khiem13052003/three_wheel_omni_robot/omni_robot_3D/gia công/Assem1.SLDASM

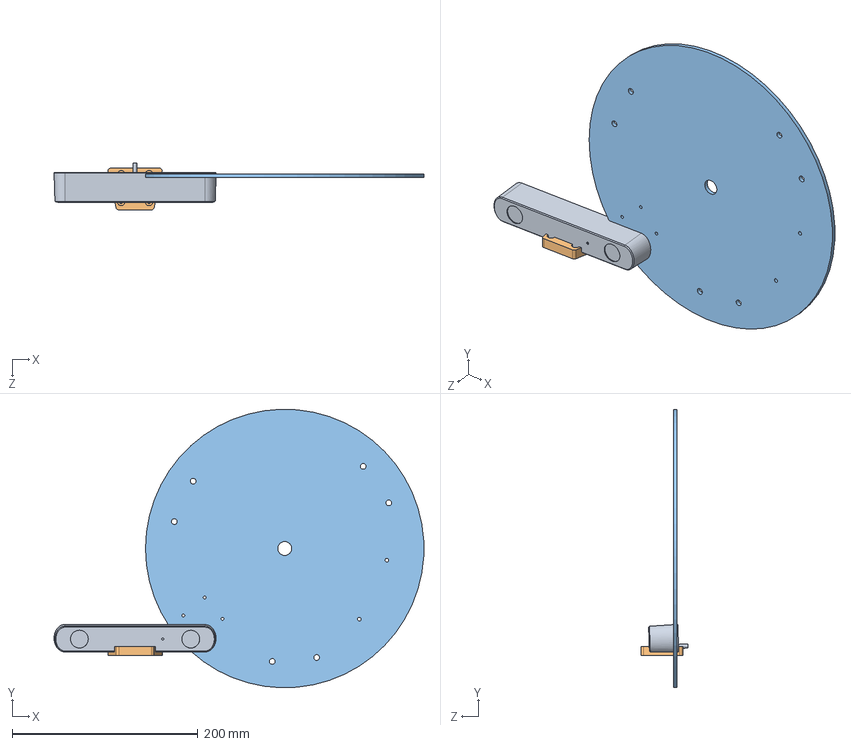
[picture p78: CAD file, 2026-04-22]
omni_robot_3D/gia công/Assem1.SLDASM
398.5 x 299.9 x 50.4 mm
DE_30_gc
camere_holder
ZED2
