khiem13052003/three_wheel_omni_robot/omni_robot_3D/Assemly.SLDASM

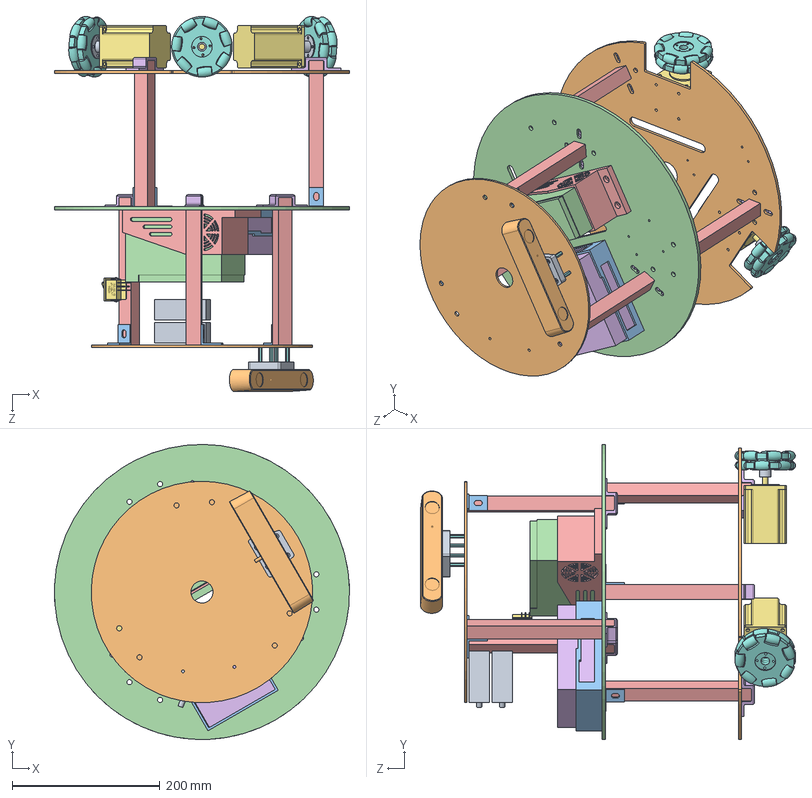
[picture p80: CAD file, 2026-04-22]
omni_robot_3D/Assemly.SLDASM
399.8 x 400.0 x 508.2 mm
BASE_R
JOINTS x 3
Omniwheel_82mm x 3
MOTOR x 3
PAS_U x 6
PILLER x 6
BASE_R_F2
KEGOC x 6
DE_30
RIGHT_BOX x 2
TRU_LUC_GIAC x 4
KCD4_ROCKET_SWITCH
JETSON
BATTERY_HOLDER
BATERY
ZED2
camere_holder
