khiem13052003/three_wheel_omni_robot/meshes/base_link.STL

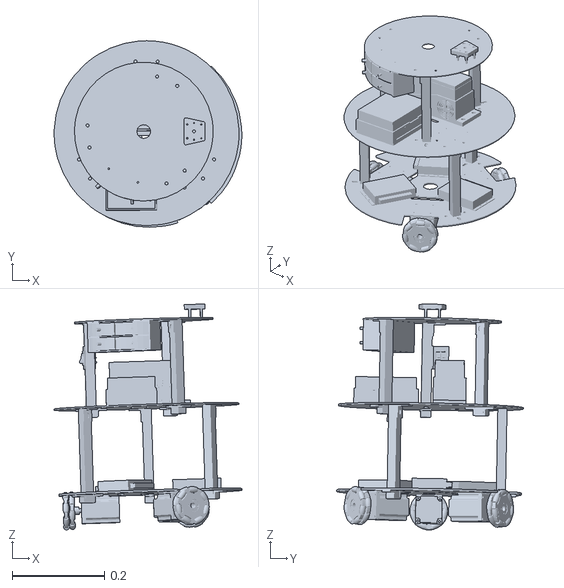
[picture p81: CAD file, 2025-07-12]
meshes/base_link.STL
0.406 x 0.403 x 0.489
