khiem13052003/three_wheel_omni_robot/omni_robot_3D/gia công/BASE_R_F2.SLDPRT

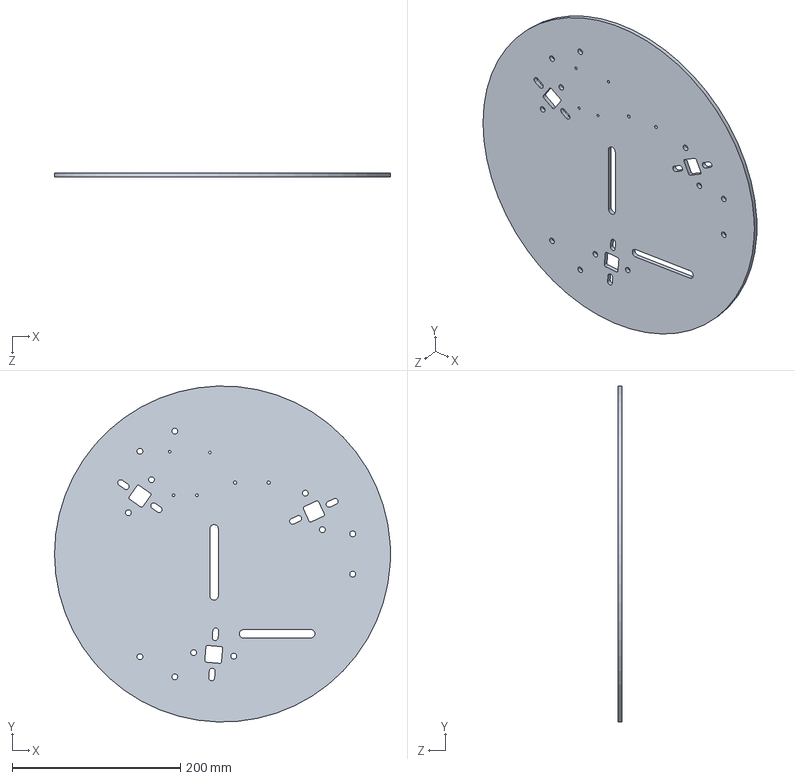
[picture p82: CAD file, 2026-04-22]
omni_robot_3D/gia công/BASE_R_F2.SLDPRT
400.0 x 399.8 x 5.00 mm
