khiem13052003/three_wheel_omni_robot/omni_robot_3D/gia công/clone1/HOPTHUOC.SLDPRT

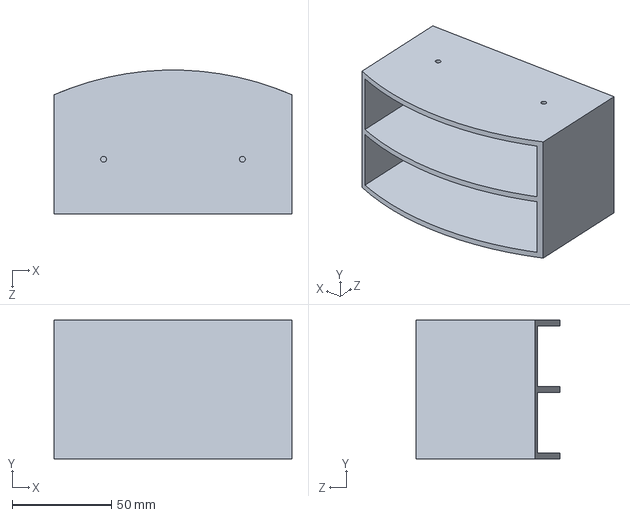
[picture p83: CAD file, 2026-04-22]
omni_robot_3D/gia công/clone1/HOPTHUOC.SLDPRT
120.0 x 70.0 x 72.4 mm
