khiem13052003/three_wheel_omni_robot/omni_robot_3D/PILLER_SWITCH.SLDPRT

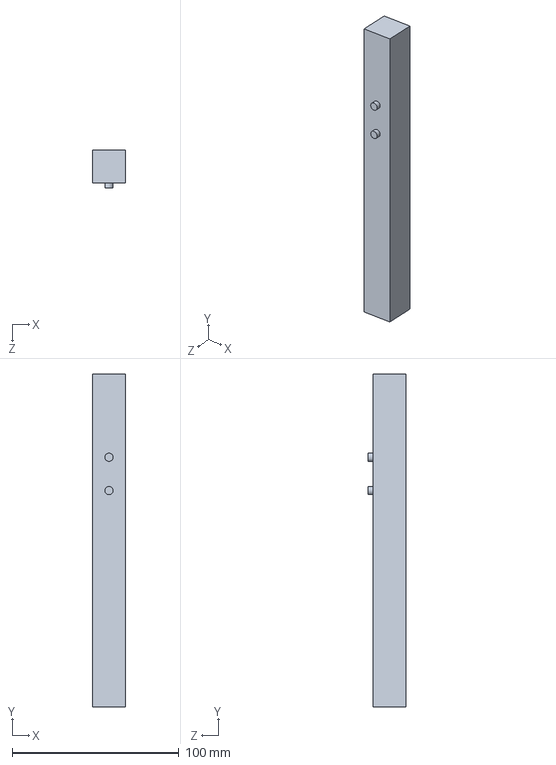
[picture p84: CAD file, 2026-04-22]
omni_robot_3D/PILLER_SWITCH.SLDPRT
20.0 x 200.0 x 23.0 mm
