khiem13052003/three_wheel_omni_robot/meshes/cam.STL

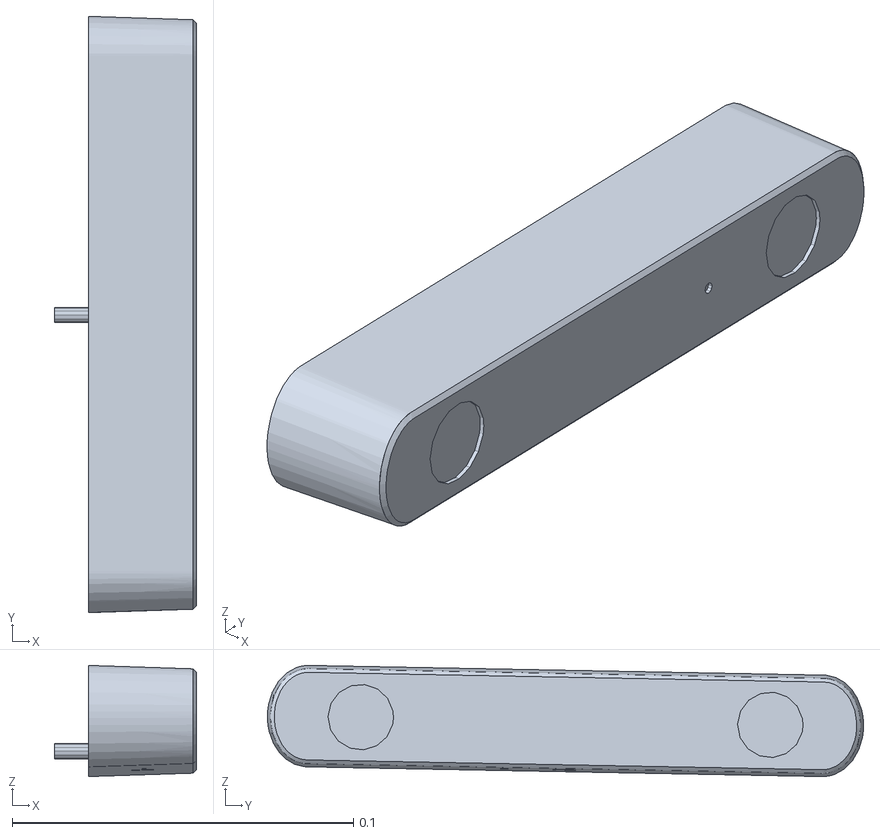
[picture p85: CAD file, 2025-07-12]
meshes/cam.STL
0.0416 x 0.175 x 0.0326
