khiem13052003/three_wheel_omni_robot/omni_robot_3D/gia công/clone1/KEGOC.SLDPRT

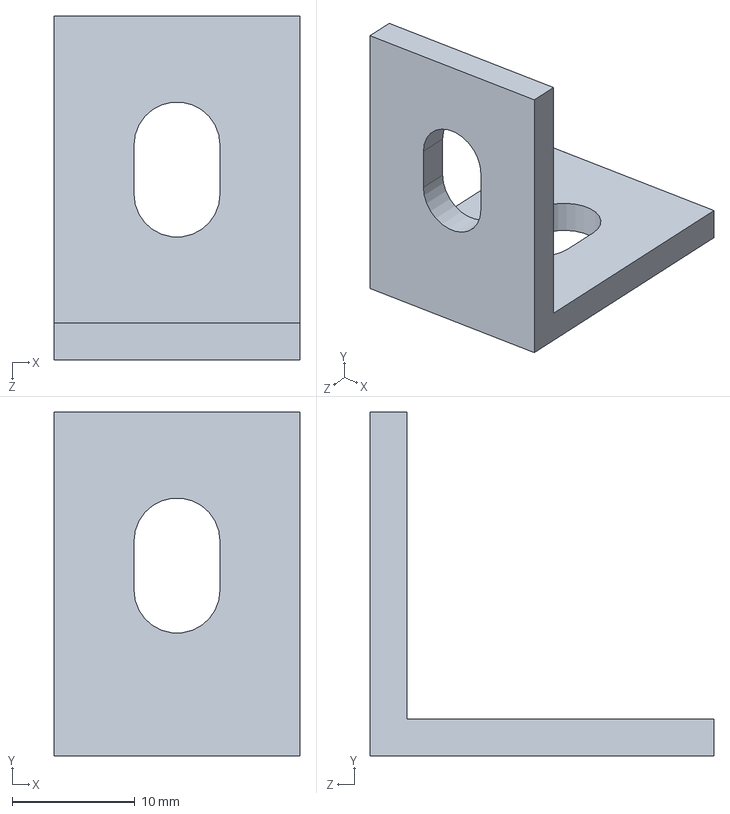
[picture p86: CAD file, 2026-04-22]
omni_robot_3D/gia công/clone1/KEGOC.SLDPRT
20.0 x 28.0 x 28.0 mm
