khiem13052003/three_wheel_omni_robot/omni_robot_3D/gia công/DE_JETSON.STL

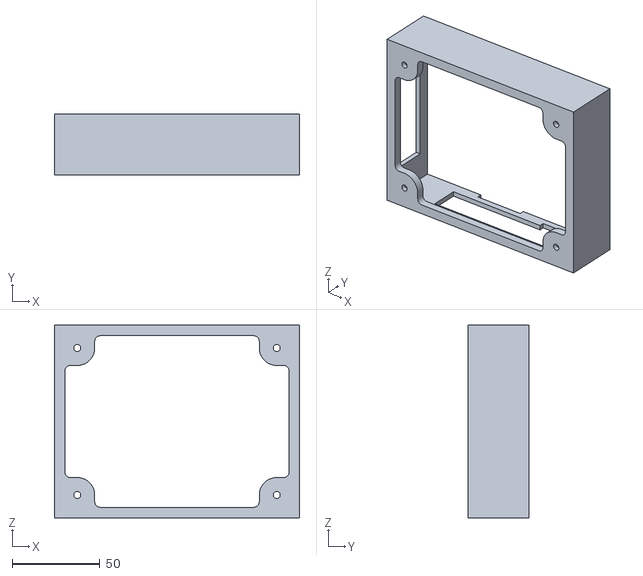
[picture p87: CAD file, 2026-04-22]
omni_robot_3D/gia công/DE_JETSON.STL
140.0 x 35.0 x 110.0
