khiem13052003/three_wheel_omni_robot/meshes/laser.STL

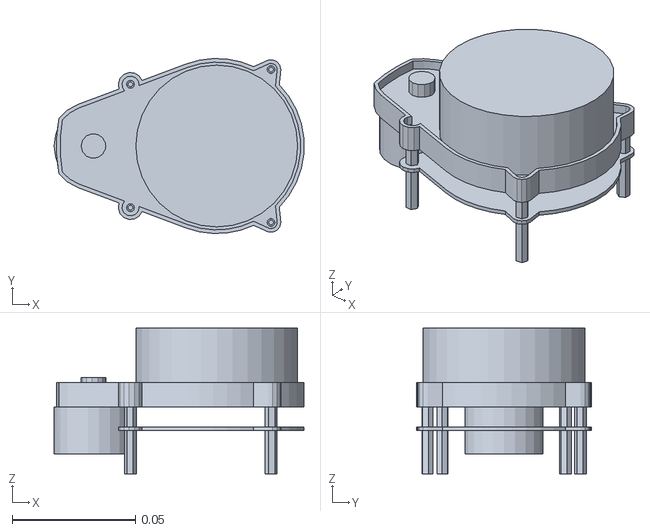
[picture p88: CAD file, 2025-07-12]
meshes/laser.STL
0.101 x 0.0709 x 0.059
