khiem13052003/three_wheel_omni_robot/omni_robot_3D/gia công/PAS_U1.STL

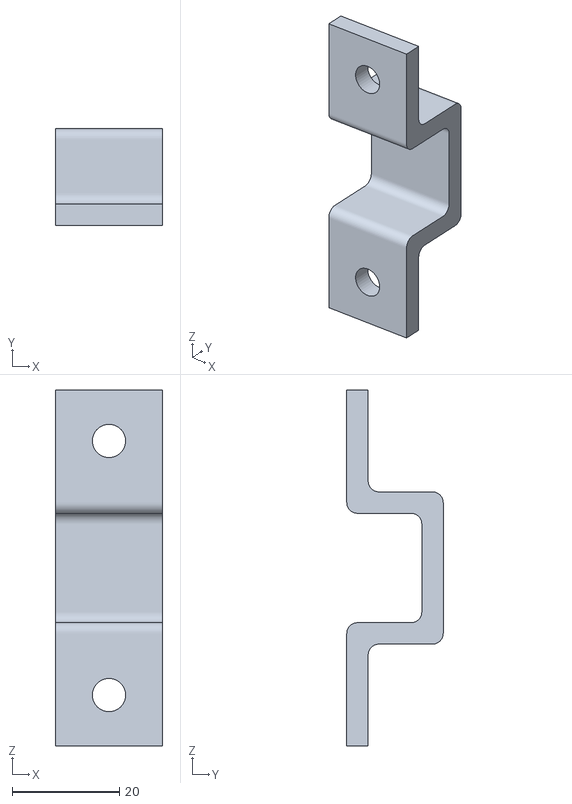
[picture p89: CAD file, 2026-04-22]
omni_robot_3D/gia công/PAS_U1.STL
20.0 x 18.0 x 66.4
