khiem13052003/three_wheel_omni_robot/omni_robot_3D/PILLER_HEXA.SLDPRT

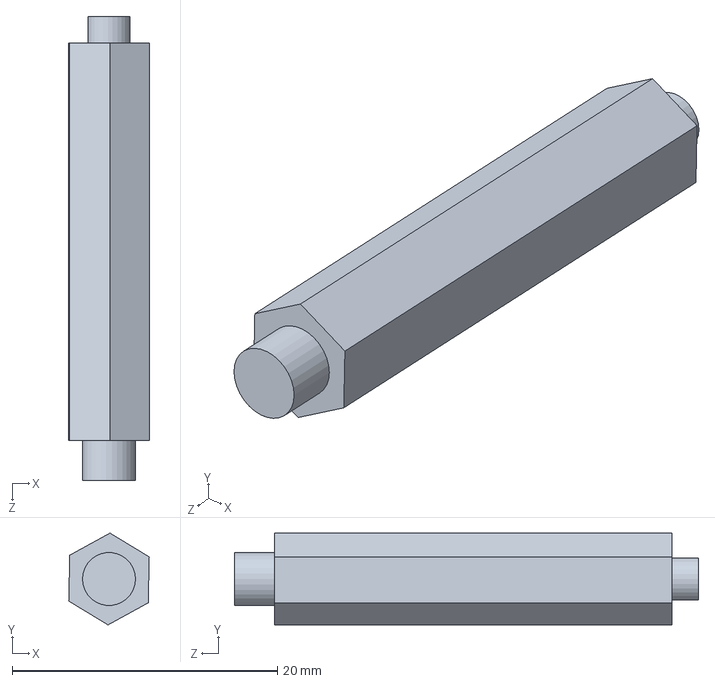
[picture p90: CAD file, 2026-04-22]
omni_robot_3D/PILLER_HEXA.SLDPRT
6.07 x 6.93 x 35.0 mm
