khiem13052003/three_wheel_omni_robot/omni_robot_3D/gia công/clone1/TRU_LUC_GIAC.SLDPRT

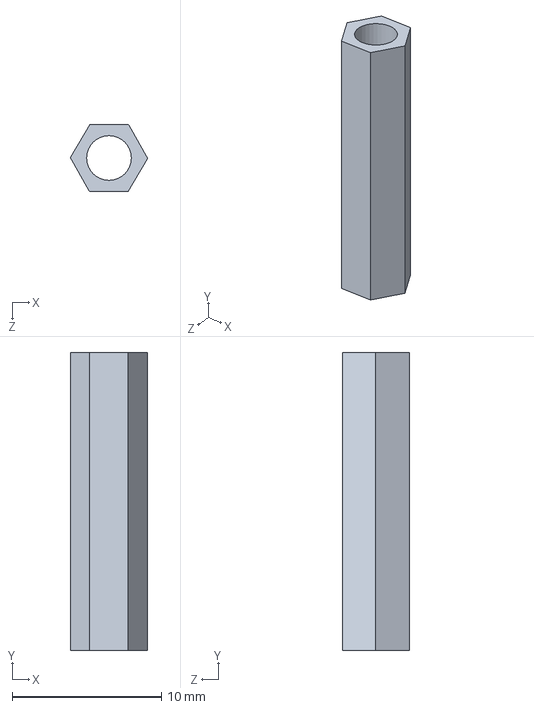
[picture p91: CAD file, 2026-04-22]
omni_robot_3D/gia công/clone1/TRU_LUC_GIAC.SLDPRT
5.20 x 20.0 x 4.53 mm
