khiem13052003/three_wheel_omni_robot/omni_robot_3D/RIGHT_BOX.SLDPRT

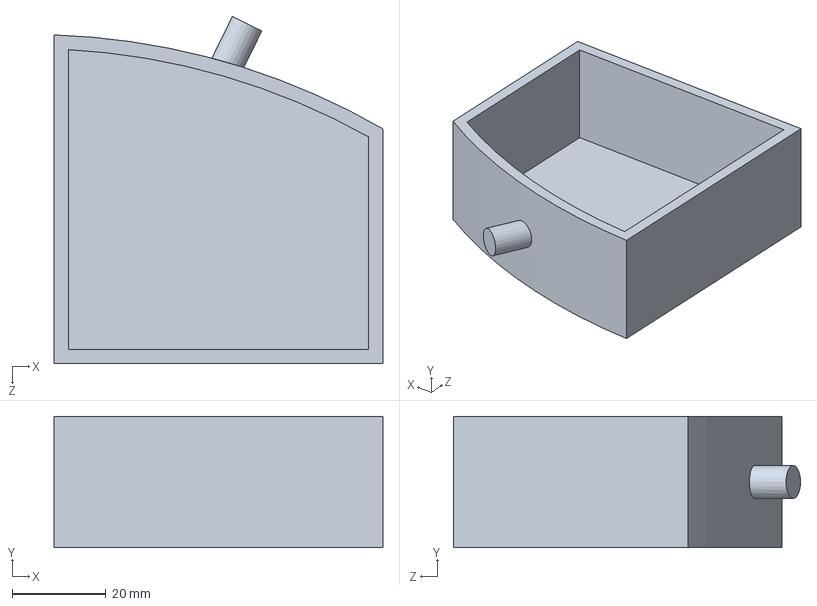
[picture p92: CAD file, 2026-04-22]
omni_robot_3D/RIGHT_BOX.SLDPRT
70.0 x 28.0 x 73.9 mm
