khiem13052003/three_wheel_omni_robot/omni_robot_3D/gia công/clone1/camere_holder.SLDPRT

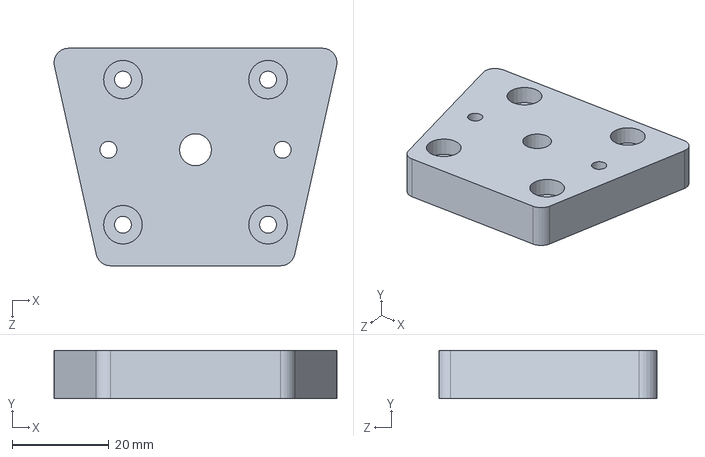
[picture p93: CAD file, 2026-04-22]
omni_robot_3D/gia công/clone1/camere_holder.SLDPRT
58.5 x 10.0 x 45.0 mm
