khiem13052003/three_wheel_omni_robot/omni_robot_3D/gia công/PAS_U.SLDPRT

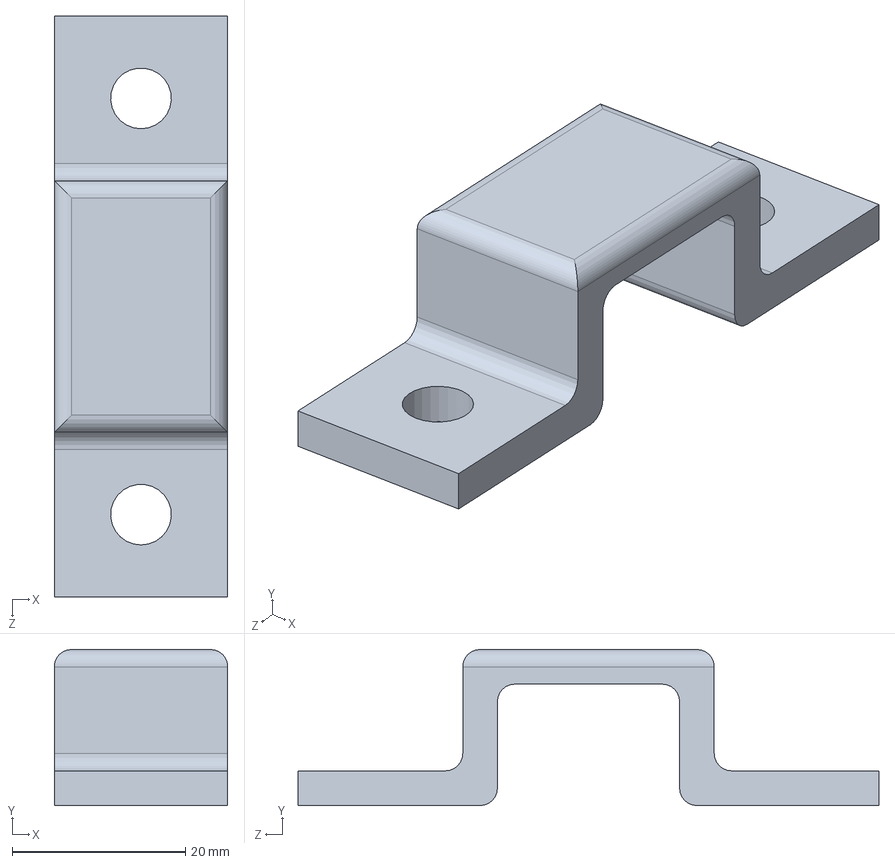
[picture p94: CAD file, 2026-04-22]
omni_robot_3D/gia công/PAS_U.SLDPRT
20.0 x 18.0 x 67.0 mm
