khiem13052003/three_wheel_omni_robot/omni_robot_3D/JETSON.SLDPRT

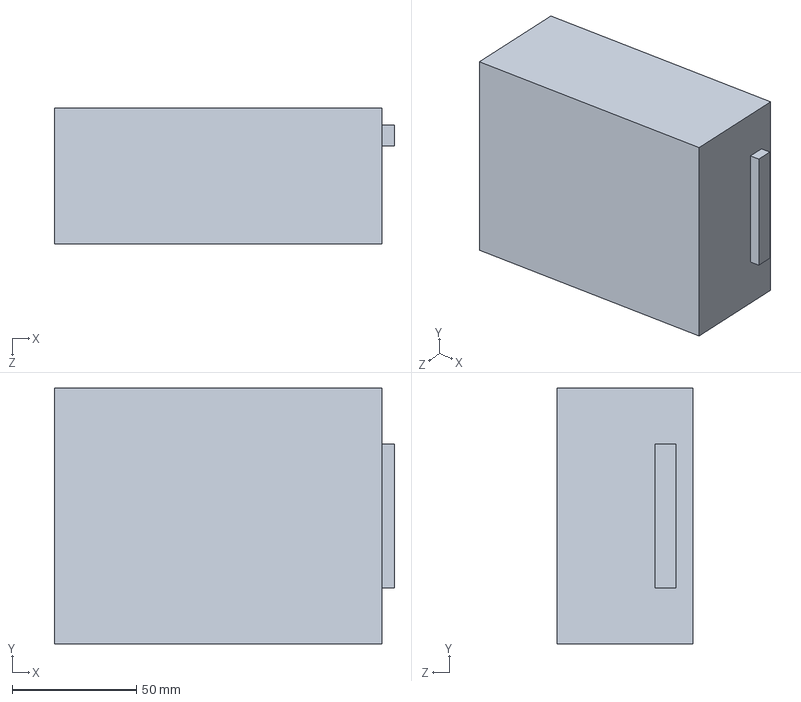
[picture p95: CAD file, 2026-04-22]
omni_robot_3D/JETSON.SLDPRT
137.0 x 103.0 x 55.0 mm
