khiem13052003/three_wheel_omni_robot/omni_robot_3D/BATTERY_HOLDER.SLDPRT

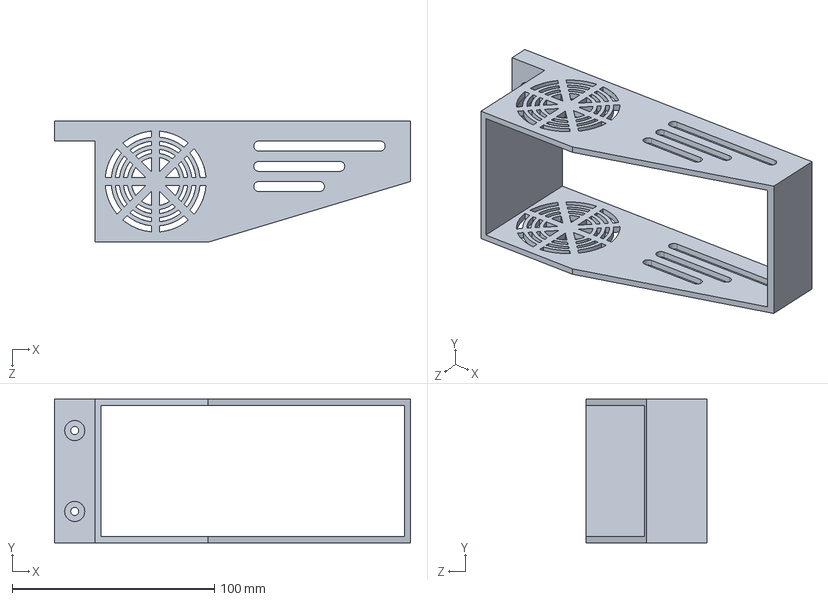
[picture p96: CAD file, 2026-04-22]
omni_robot_3D/BATTERY_HOLDER.SLDPRT
176.0 x 71.0 x 60.0 mm
