khiem13052003/three_wheel_omni_robot/omni_robot_3D/gia công/clone1/KCD4_ROCKET_SWITCH.SLDPRT

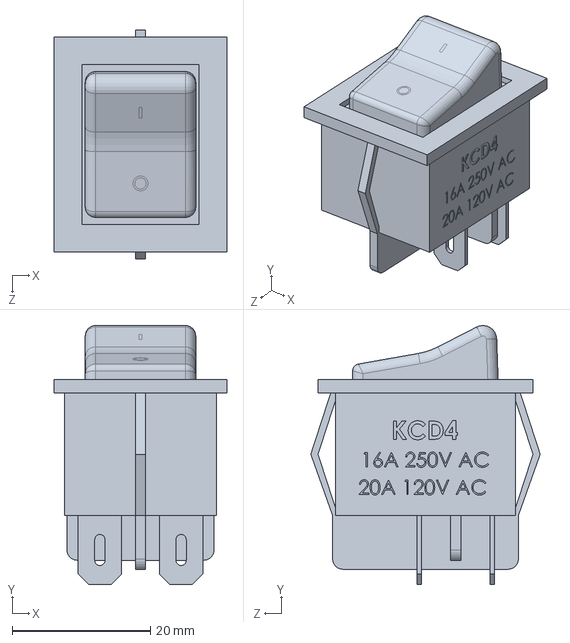
[picture p97: CAD file, 2026-04-22]
omni_robot_3D/gia công/clone1/KCD4_ROCKET_SWITCH.SLDPRT
25.0 x 37.5 x 33.2 mm
