khiem13052003/three_wheel_omni_robot/omni_robot_3D/gia công/de_trai.STL

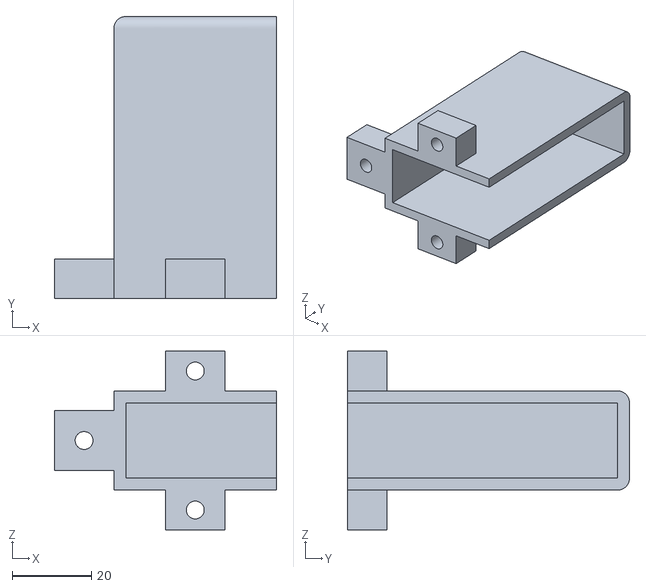
[picture p98: CAD file, 2026-04-22]
omni_robot_3D/gia công/de_trai.STL
56.0 x 71.0 x 45.0
