khiem13052003/three_wheel_omni_robot/omni_robot_3D/DE_30.SLDPRT

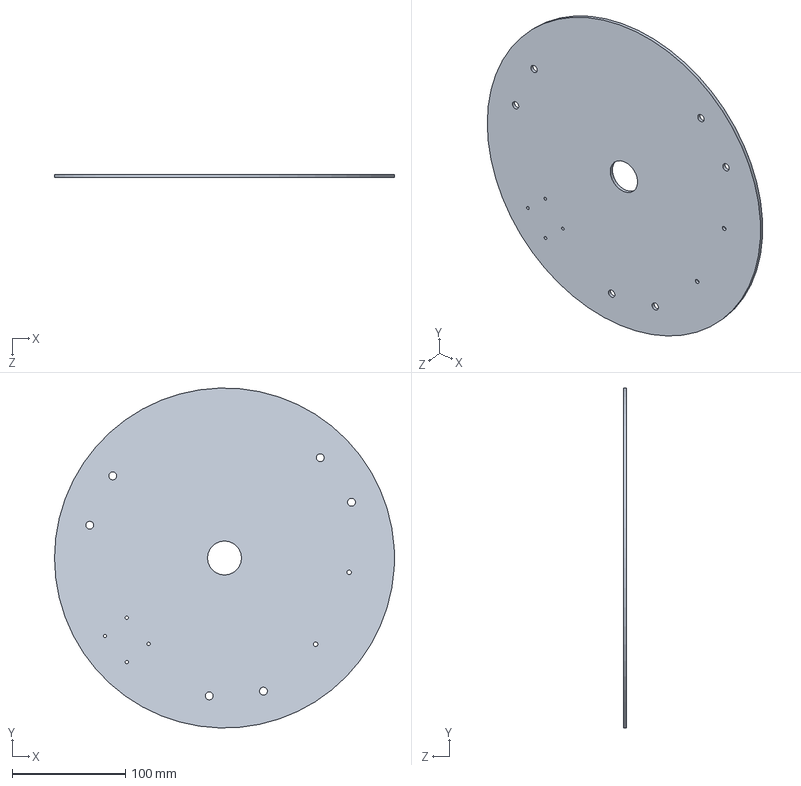
[picture p99: CAD file, 2026-04-22]
omni_robot_3D/DE_30.SLDPRT
300.0 x 299.9 x 3.00 mm
