khiem13052003/three_wheel_omni_robot/omni_robot_3D/gia công/clone1/MOTOR.SLDPRT

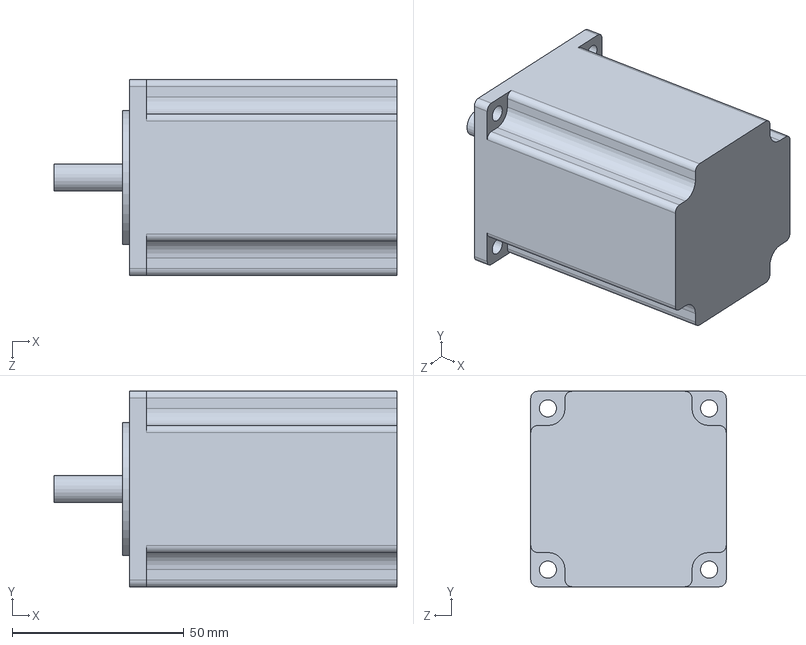
[picture p100: CAD file, 2026-04-22]
omni_robot_3D/gia công/clone1/MOTOR.SLDPRT
100.0 x 57.0 x 57.0 mm
