khiem13052003/three_wheel_omni_robot/omni_robot_3D/gia công/DE_30_gc.SLDPRT

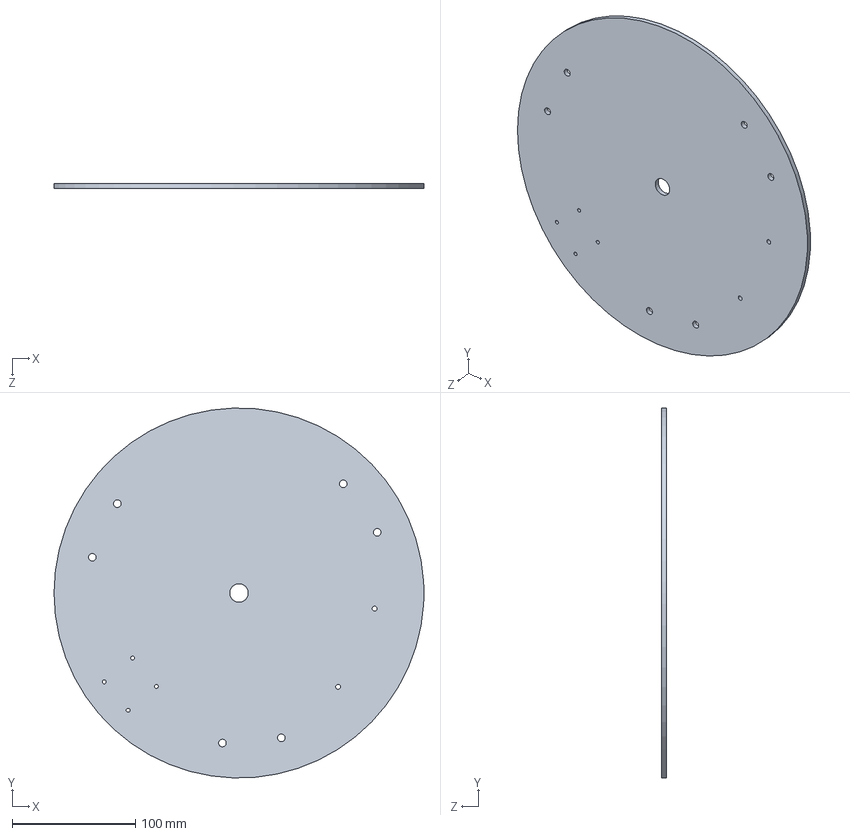
[picture p101: CAD file, 2026-04-22]
omni_robot_3D/gia công/DE_30_gc.SLDPRT
300.0 x 299.9 x 4.00 mm
