khiem13052003/three_wheel_omni_robot/omni_robot_3D/gia công/ZED2.SLDPRT

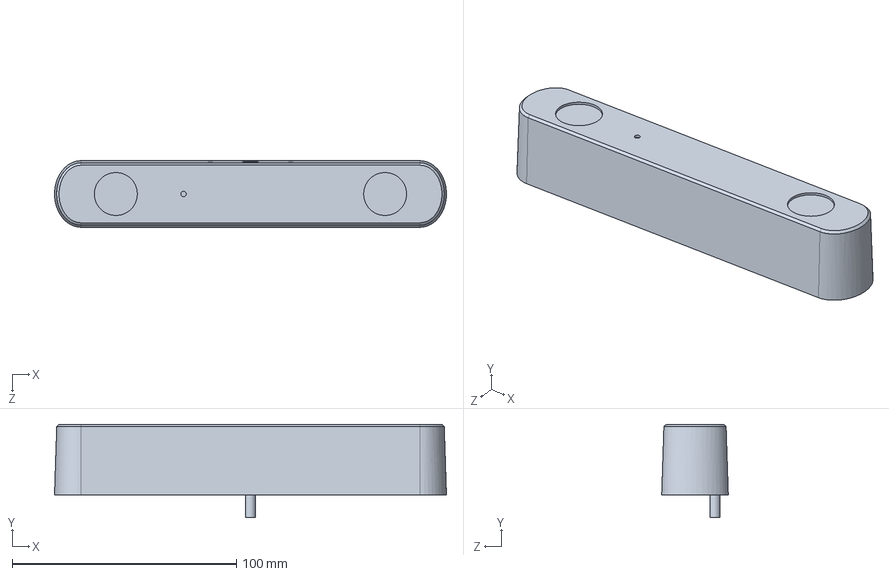
[picture p103: CAD file, 2026-04-22]
omni_robot_3D/gia công/ZED2.SLDPRT
174.7 x 41.6 x 29.7 mm
