khiem13052003/three_wheel_omni_robot/omni_robot_3D/gia công/DRAWER.SLDPRT

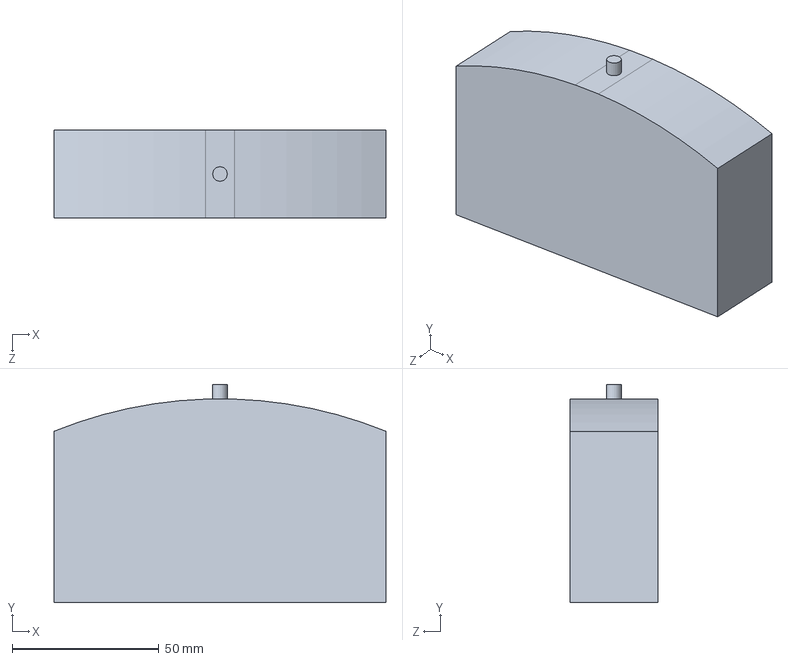
[picture p104: CAD file, 2026-04-22]
omni_robot_3D/gia công/DRAWER.SLDPRT
113.0 x 74.3 x 30.0 mm
