khiem13052003/three_wheel_omni_robot/omni_robot_3D/JOINTS.SLDPRT

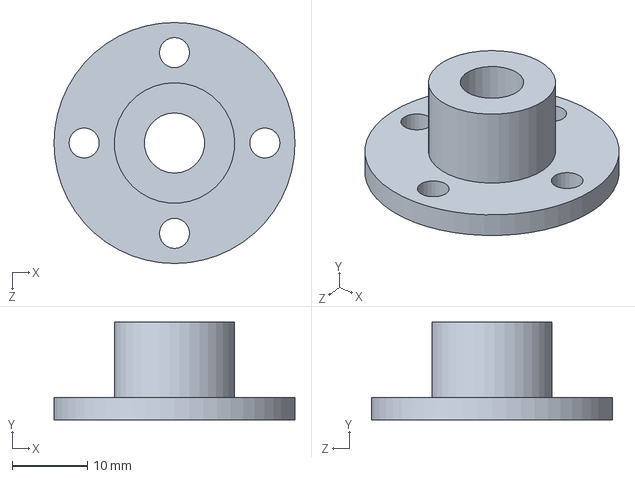
[picture p105: CAD file, 2026-04-22]
omni_robot_3D/JOINTS.SLDPRT
32.0 x 13.0 x 32.0 mm
