khiem13052003/three_wheel_omni_robot/omni_robot_3D/gia công/clone1/Omniwheel_82mm.SLDPRT

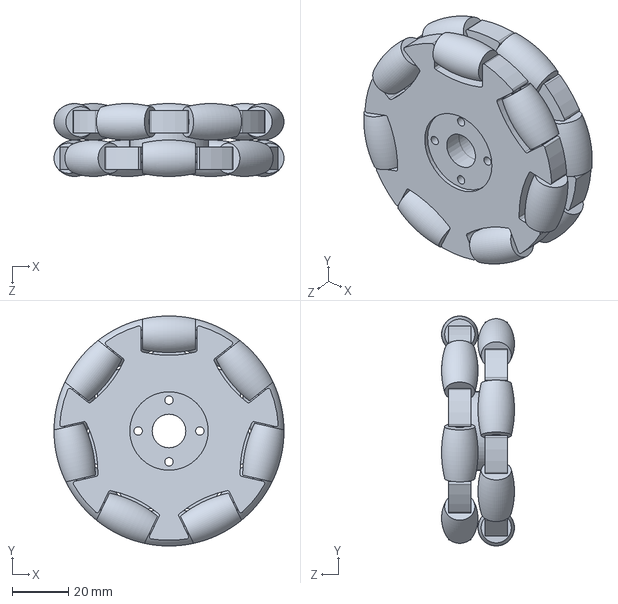
[picture p106: CAD file, 2026-04-22]
omni_robot_3D/gia công/clone1/Omniwheel_82mm.SLDPRT
82.0 x 82.0 x 26.0 mm
