khiem13052003/three_wheel_omni_robot/omni_robot_3D/gia công/DE_30.DXF

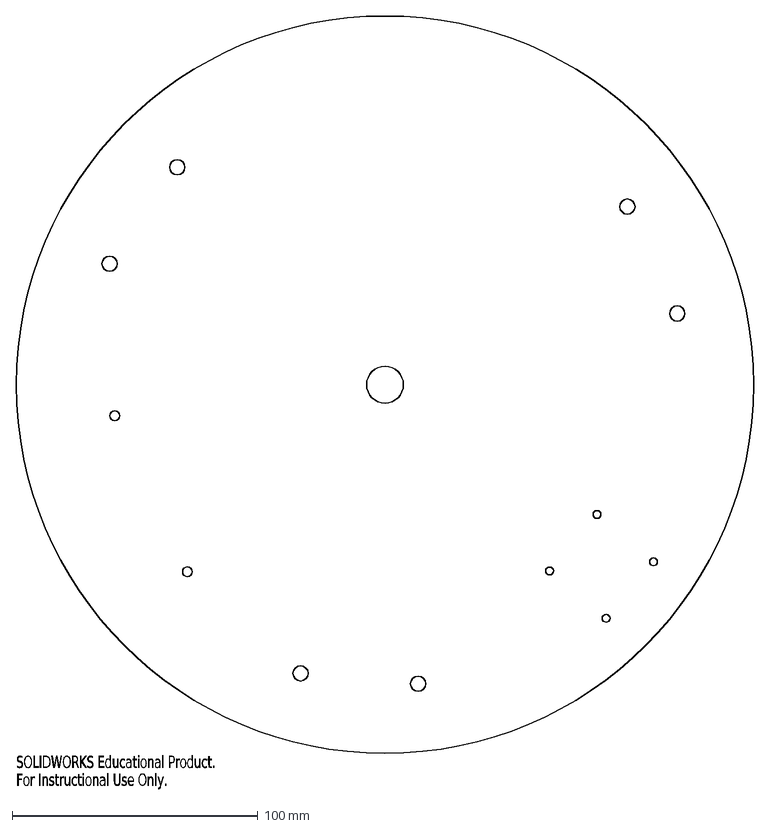
[picture p107: CAD file, 2026-04-22]
omni_robot_3D/gia công/DE_30.DXF
SOLIDWORKS Educational Product.
For Instructional Use Only.
