khiem13052003/three_wheel_omni_robot/omni_robot_3D/Part1.SLDPRT

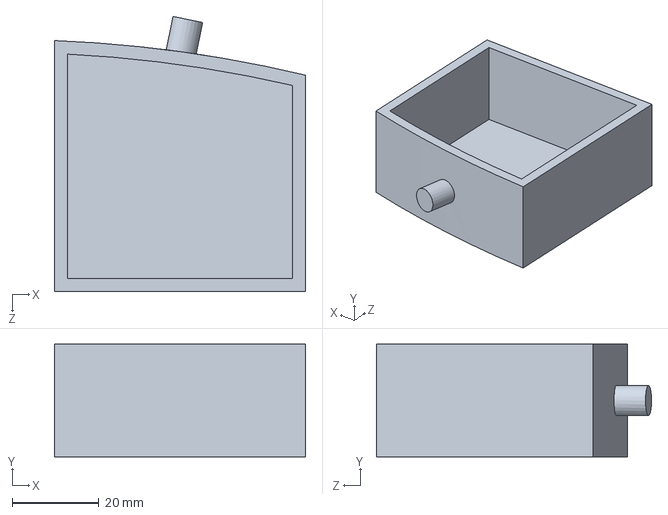
[picture p108: CAD file, 2026-04-22]
omni_robot_3D/Part1.SLDPRT
58.0 x 26.0 x 63.6 mm
