khiem13052003/three_wheel_omni_robot/omni_robot_3D/gia công/BASE_R.SLDPRT

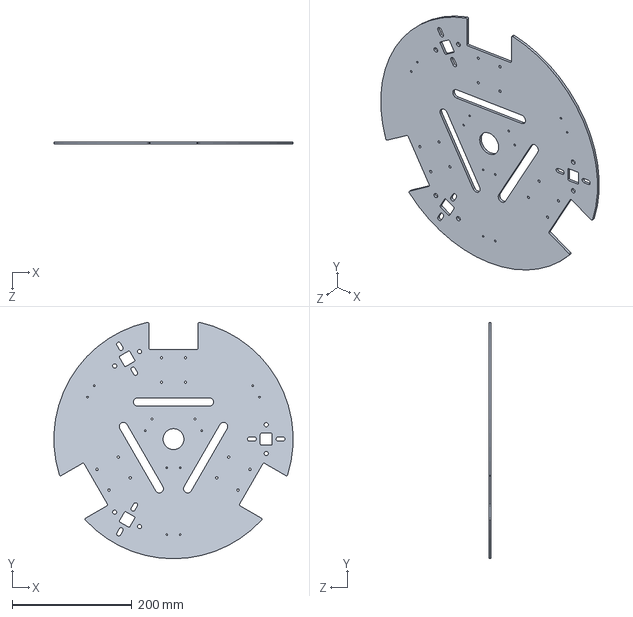
[picture p109: CAD file, 2026-04-22]
omni_robot_3D/gia công/BASE_R.SLDPRT
399.5 x 395.3 x 4.00 mm
