khiem13052003/three_wheel_omni_robot/omni_robot_3D/gia công/clone1/PILLER.SLDPRT

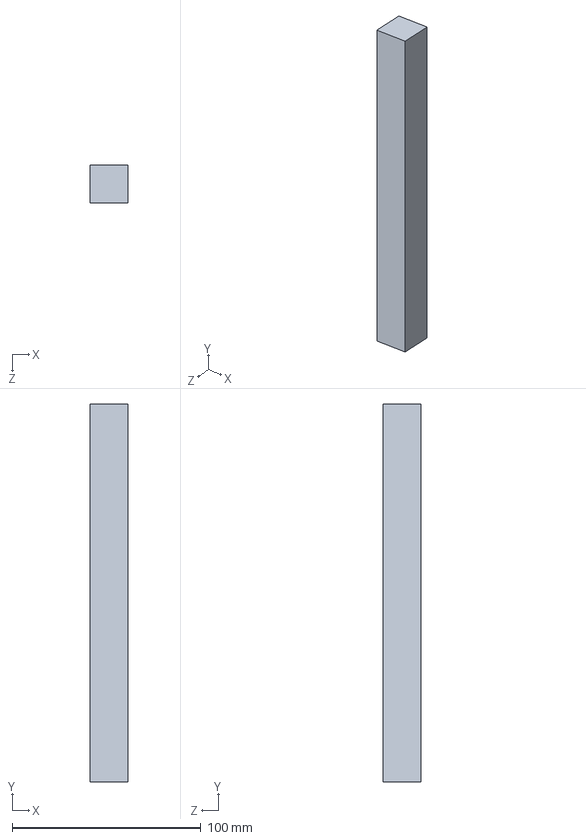
[picture p110: CAD file, 2026-04-22]
omni_robot_3D/gia công/clone1/PILLER.SLDPRT
20.0 x 200.0 x 20.0 mm
