khiem13052003/three_wheel_omni_robot/omni_robot_3D/gia công/Basler_holder.STL

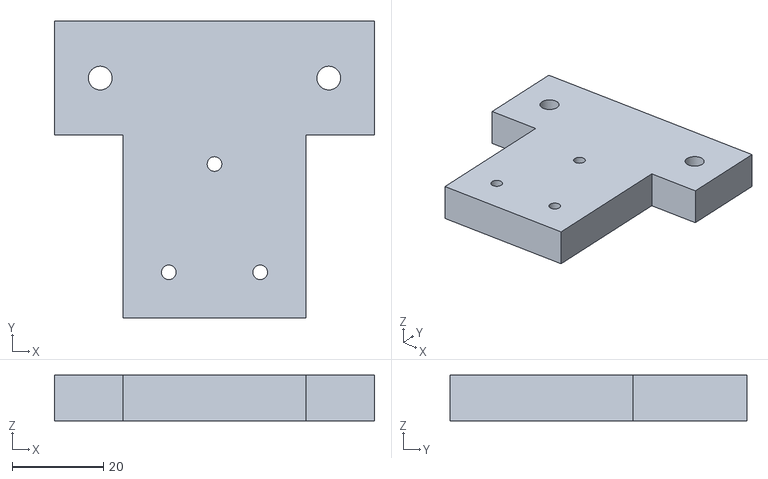
[picture p111: CAD file, 2026-04-22]
omni_robot_3D/gia công/Basler_holder.STL
70.0 x 65.0 x 10.0
