khiem13052003/three_wheel_omni_robot/omni_robot_3D/BATERY.SLDPRT

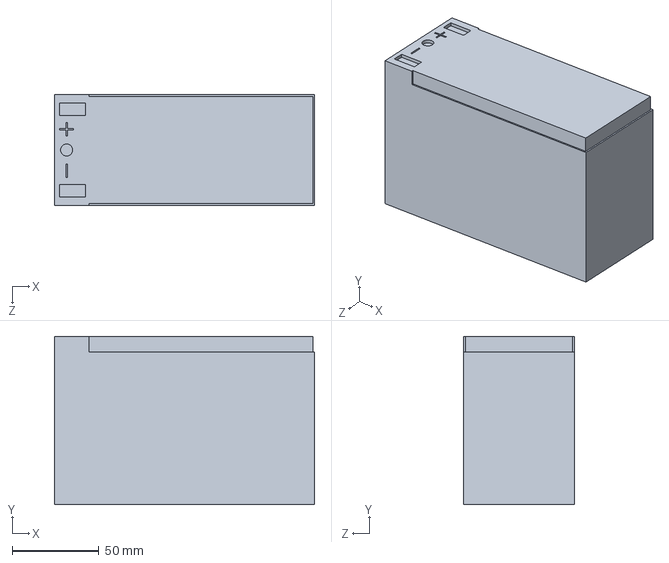
[picture p112: CAD file, 2026-04-22]
omni_robot_3D/BATERY.SLDPRT
150.0 x 97.0 x 64.0 mm
