khiem13052003/three_wheel_omni_robot/omni_robot_3D/gia công/1-3base.SLDPRT

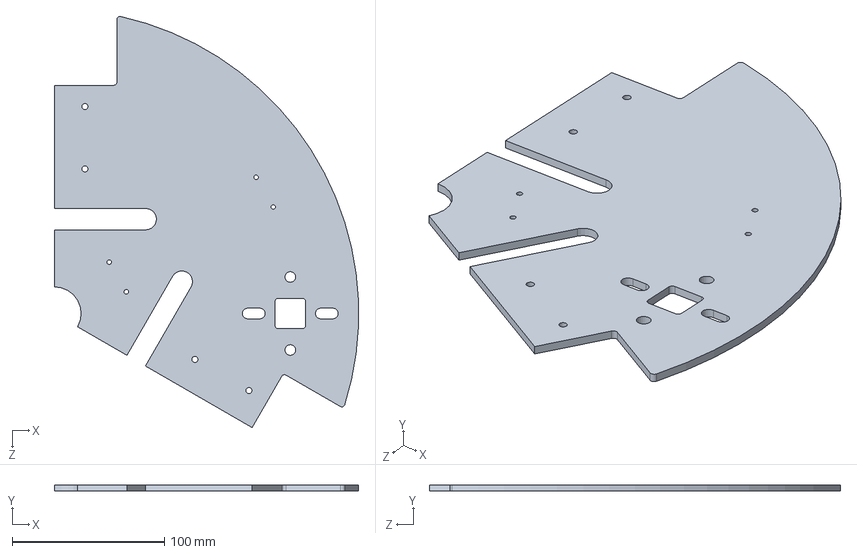
[picture p113: CAD file, 2026-04-22]
omni_robot_3D/gia công/1-3base.SLDPRT
199.8 x 4.00 x 270.3 mm
