khiem13052003/three_wheel_omni_robot/omni_robot_3D/gia công/clone1/camera_hoder2.SLDPRT

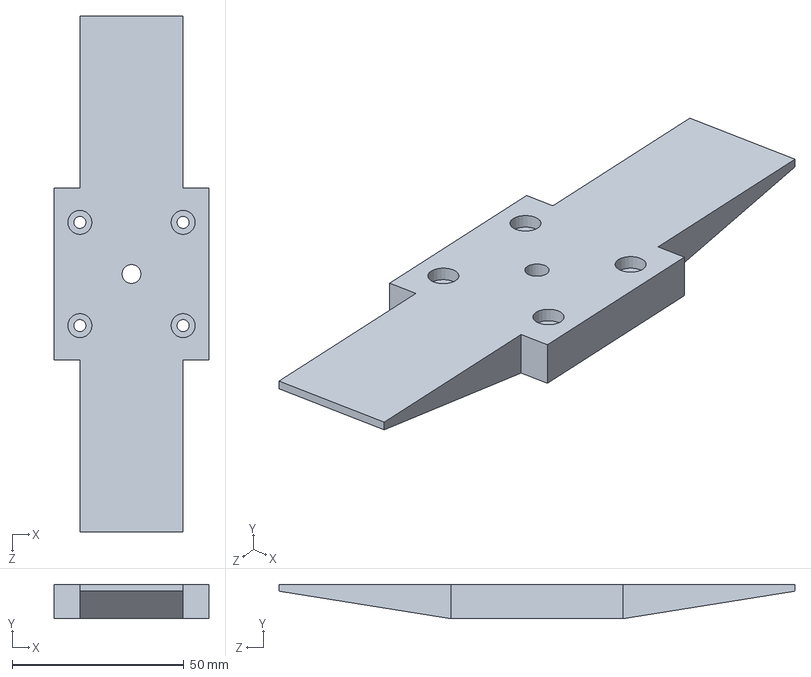
[picture p114: CAD file, 2026-04-22]
omni_robot_3D/gia công/clone1/camera_hoder2.SLDPRT
45.0 x 10.0 x 150.0 mm
