khiem13052003/three_wheel_omni_robot/omni_robot_3D/L_CARRY.SLDPRT

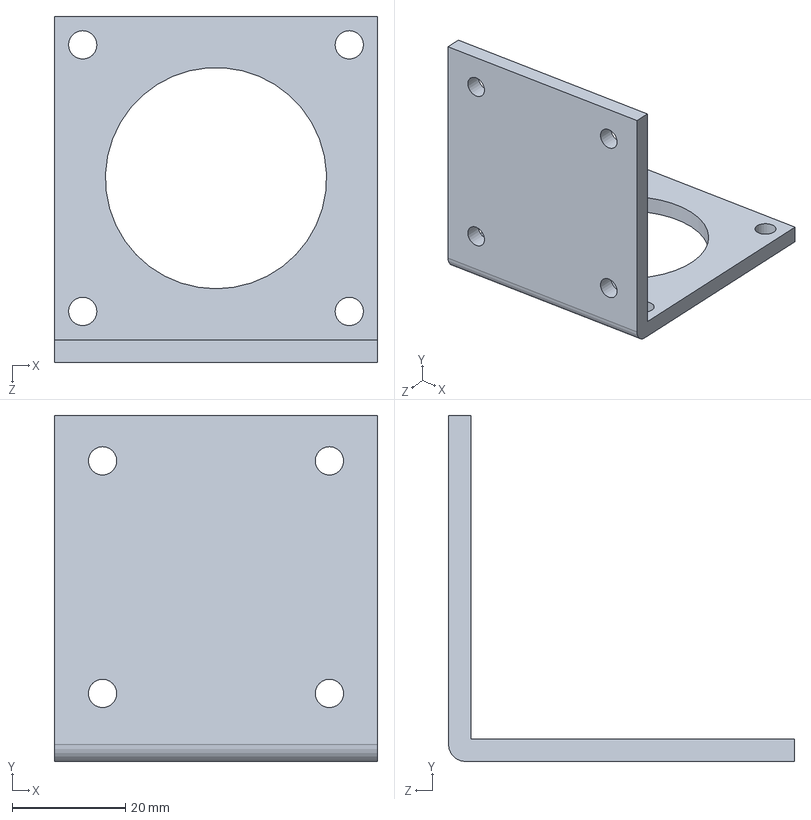
[picture p115: CAD file, 2026-04-22]
omni_robot_3D/L_CARRY.SLDPRT
57.0 x 61.0 x 61.0 mm
