khiem13052003/three_wheel_omni_robot/omni_robot_3D/Arduino.SLDPRT

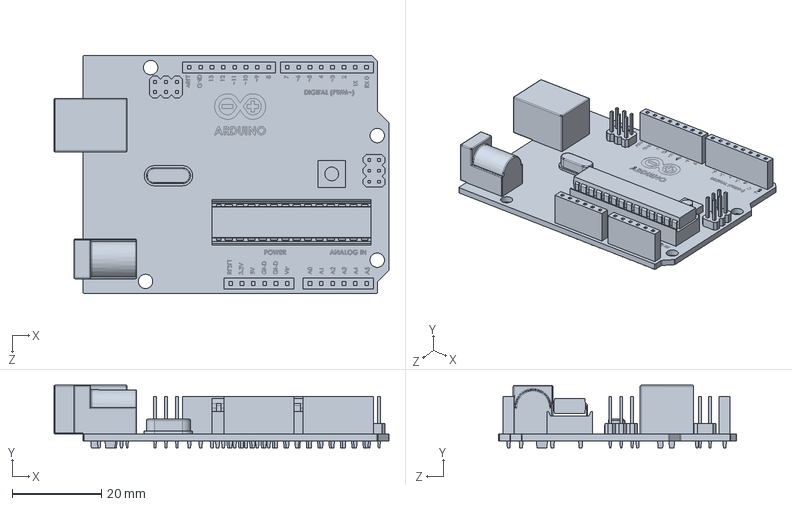
[picture p116: CAD file, 2026-04-22]
omni_robot_3D/Arduino.SLDPRT
75.1 x 14.0 x 53.3 mm
