khiem13052003/three_wheel_omni_robot/omni_robot_3D/LEFT_BOX.SLDPRT

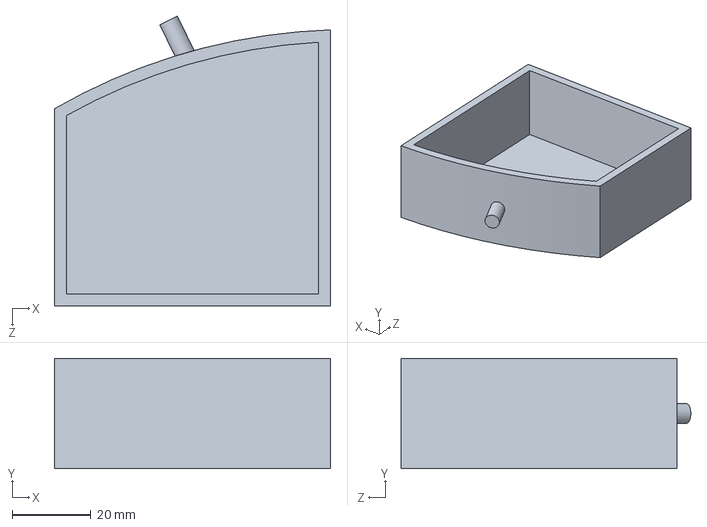
[picture p117: CAD file, 2026-04-22]
omni_robot_3D/LEFT_BOX.SLDPRT
70.0 x 28.0 x 73.5 mm
