khiem13052003/three_wheel_omni_robot/omni_robot_3D/HOP_THUOC.SLDPRT

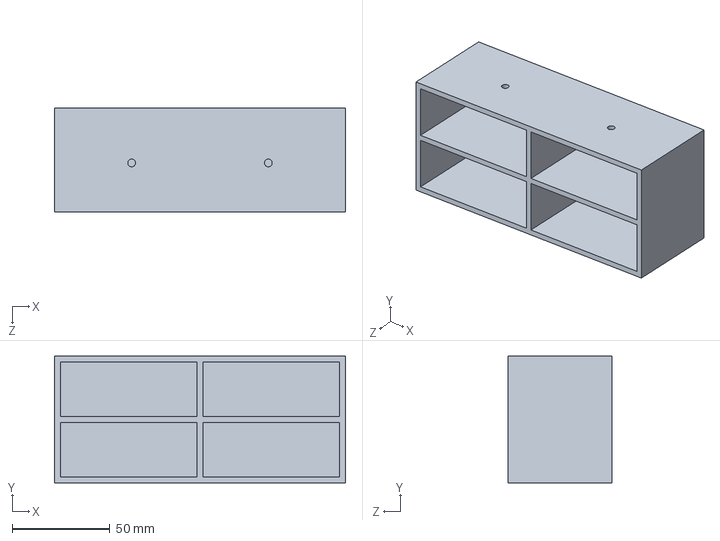
[picture p118: CAD file, 2026-04-22]
omni_robot_3D/HOP_THUOC.SLDPRT
149.0 x 65.0 x 53.0 mm
