khiem13052003/three_wheel_omni_robot/omni_robot_3D/gia công/clone1/ydlidar x4.SLDPRT

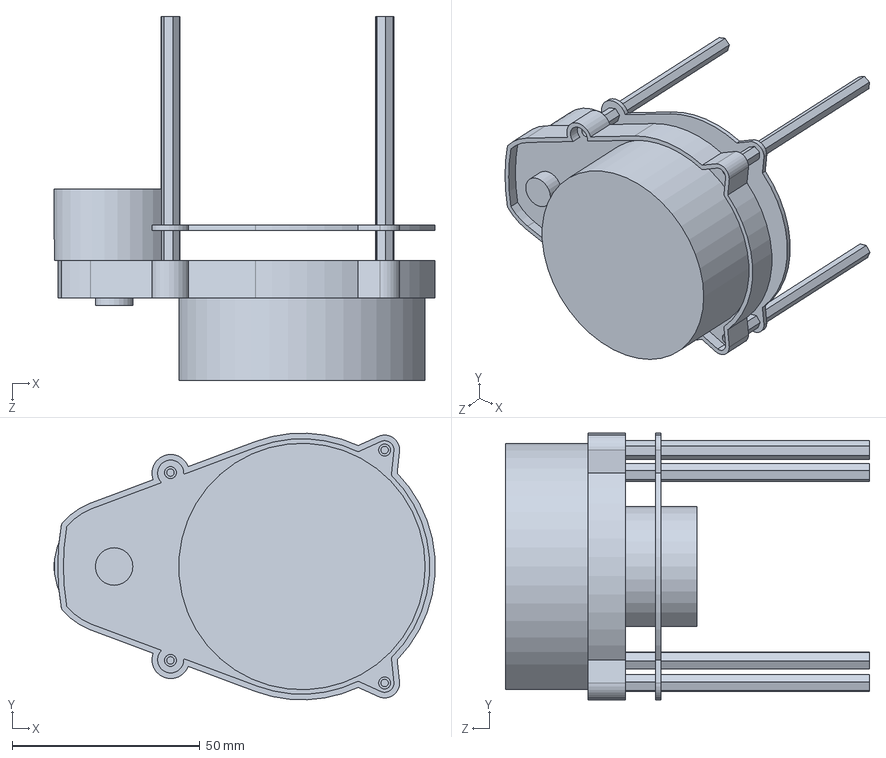
[picture p119: CAD file, 2026-04-22]
omni_robot_3D/gia công/clone1/ydlidar x4.SLDPRT
101.4 x 70.9 x 97.0 mm
