khiem13052003/three_wheel_omni_robot/omni_robot_3D/DIVER.SLDPRT

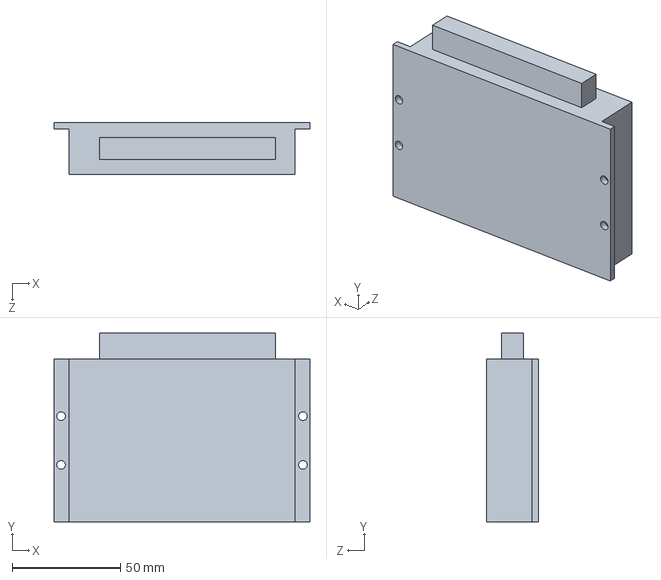
[picture p120: CAD file, 2026-04-22]
omni_robot_3D/DIVER.SLDPRT
118.0 x 87.0 x 24.0 mm
