khiem13052003/three_wheel_omni_robot/omni_robot_3D/gia công/clone1/Part2.SLDPRT

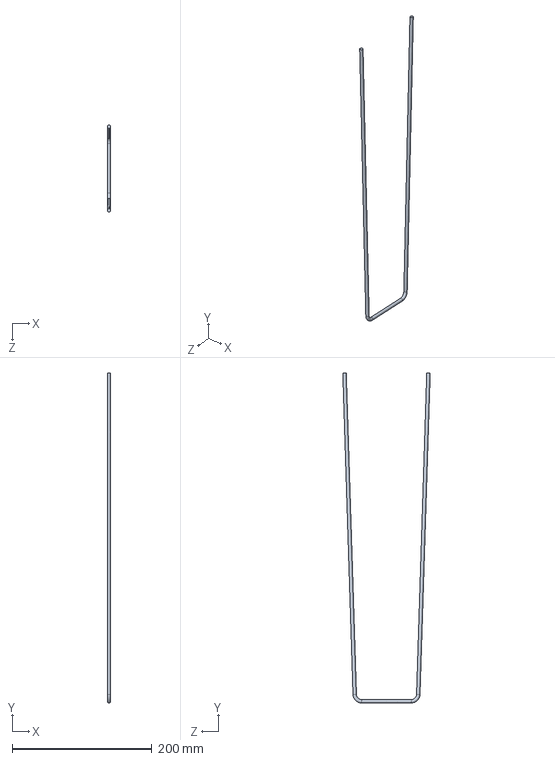
[picture p121: CAD file, 2026-04-22]
omni_robot_3D/gia công/clone1/Part2.SLDPRT
4.99 x 471.8 x 125.0 mm
