khiem13052003/three_wheel_omni_robot/omni_robot_3D/SW_HOLDER.SLDPRT

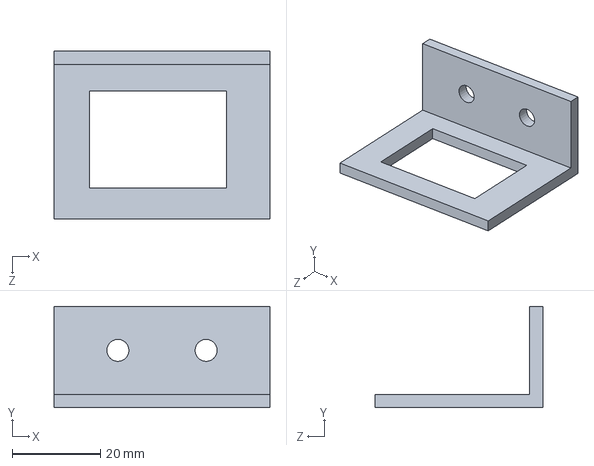
[picture p122: CAD file, 2026-04-22]
omni_robot_3D/SW_HOLDER.SLDPRT
49.0 x 23.0 x 38.0 mm
