khiem13052003/three_wheel_omni_robot/omni_robot_3D/ydlidar x4.SLDPRT

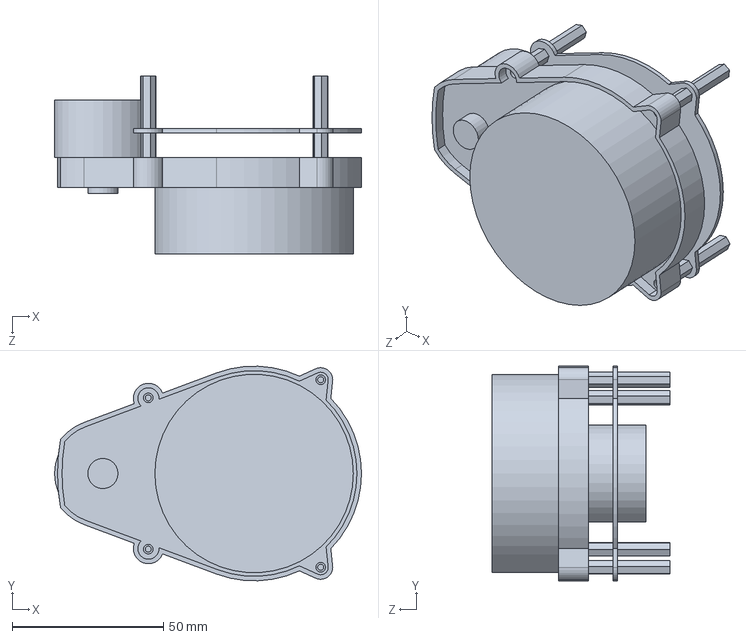
[picture p123: CAD file, 2026-04-22]
omni_robot_3D/ydlidar x4.SLDPRT
101.5 x 70.9 x 59.0 mm
