khiem13052003/three_wheel_omni_robot/omni_robot_3D/gia công/clone1/HEAD_SHIEL.SLDPRT

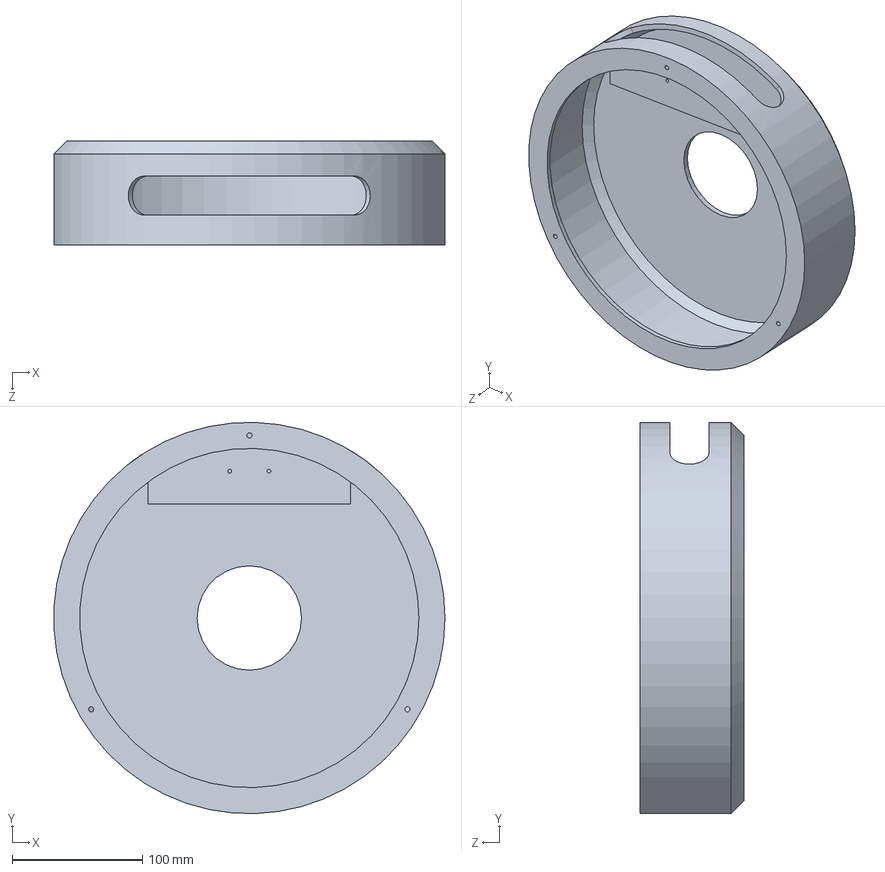
[picture p124: CAD file, 2026-04-22]
omni_robot_3D/gia công/clone1/HEAD_SHIEL.SLDPRT
299.7 x 299.9 x 80.0 mm
