khiem13052003/three_wheel_omni_robot/(list of files, cad)

Other CAD files:
omni_robot_3D/Part3.SLDPRT
omni_robot_3D/gia công/clone1/Part3.SLDPRT
omni_robot_3D/gia công/camere_holder.STL
omni_robot_3D/POWER_BOX.SLDPRT
omni_robot_3D/gia công/clone1/DRAWER.SLDPRT
omni_robot_3D/gia công/HOPTHUOC.SLDPRT
omni_robot_3D/gia công/clone1/Basler_holder.SLDPRT
omni_robot_3D/gia công/clone1/POWER_BOX.SLDPRT
omni_robot_3D/gia công/clone1/PAS_U.SLDPRT
omni_robot_3D/gia công/clone1/DE_30.SLDPRT
omni_robot_3D/BASE_R.SLDPRT
omni_robot_3D/gia công/clone1/BASE_R.SLDPRT
omni_robot_3D/PAS_U.SLDPRT
omni_robot_3D/BASE_R.SLDDRW
omni_robot_3D/gia công/BASE_R.SLDDRW
omni_robot_3D/gia công/BASE_R_F2.DXF
omni_robot_3D/gia công/BASE_R_F2.SLDDRW
omni_robot_3D/gia công/DRAWER.STL
omni_robot_3D/gia công/HOPTHUOC.STL
omni_robot_3D/gia công/clone1/BASE_R.SLDDRW
omni_robot_3D/gia công/de_trai - Copy.STL
