khiem13052003/three_wheel_omni_robot/omni_robot_3D/gia công/BASE_R.pdf

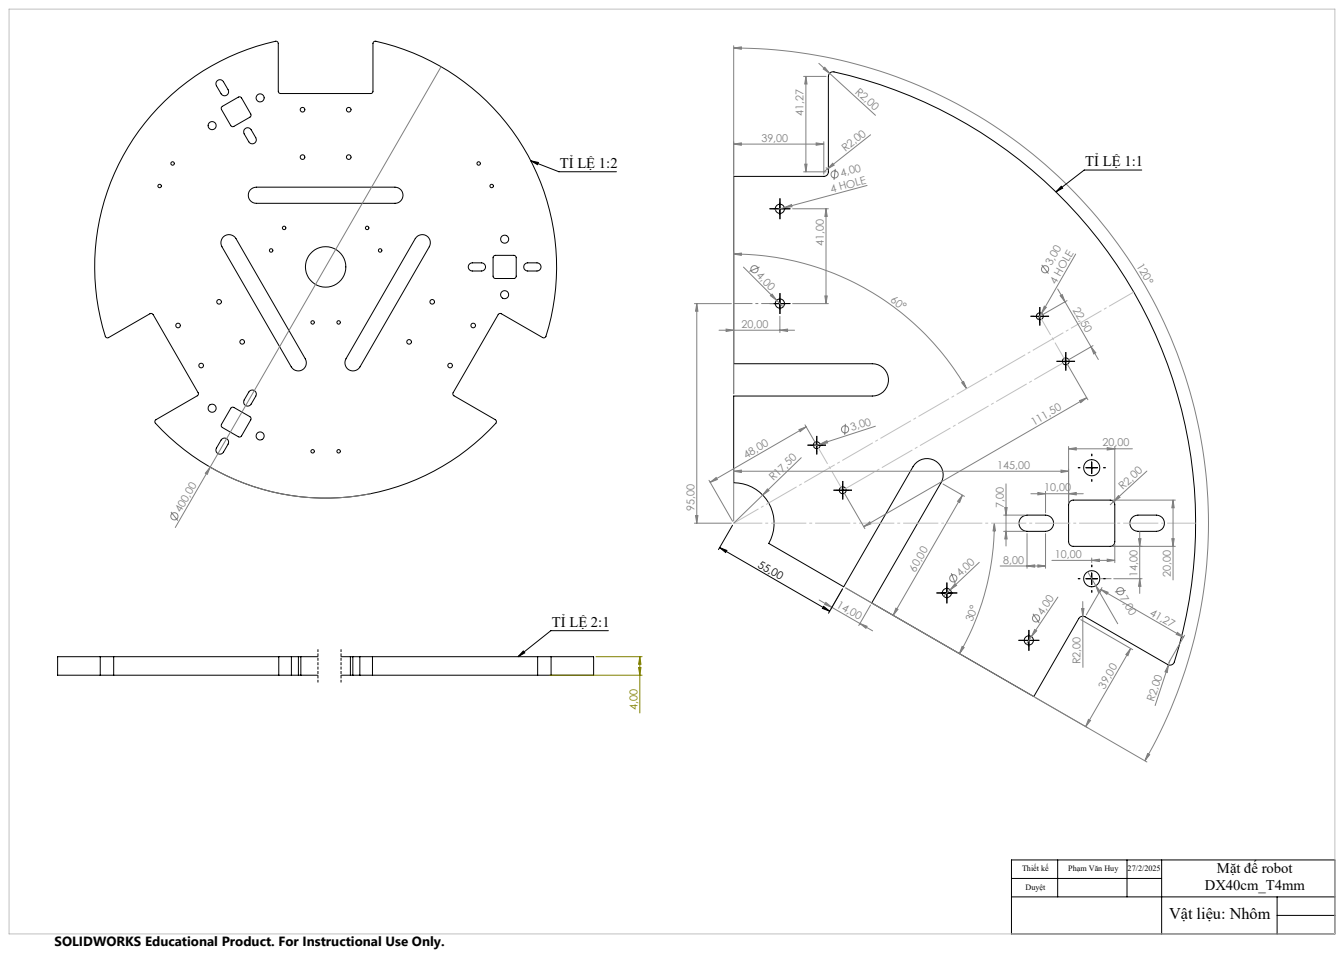
[picture p125: page 1]
4 HOLE

Thiết kế | Phạm Văn Huy | 27/2/2025 | Mặt đế robot DX40cm_T4mm

Duyệt

Vật liệu: Nhôm

SOLIDWORKS Educational Product. For Instructional Use Only.
