khiem13052003/three_wheel_omni_robot/omni_robot_3D/gia công/BASE_R_F2.pdf

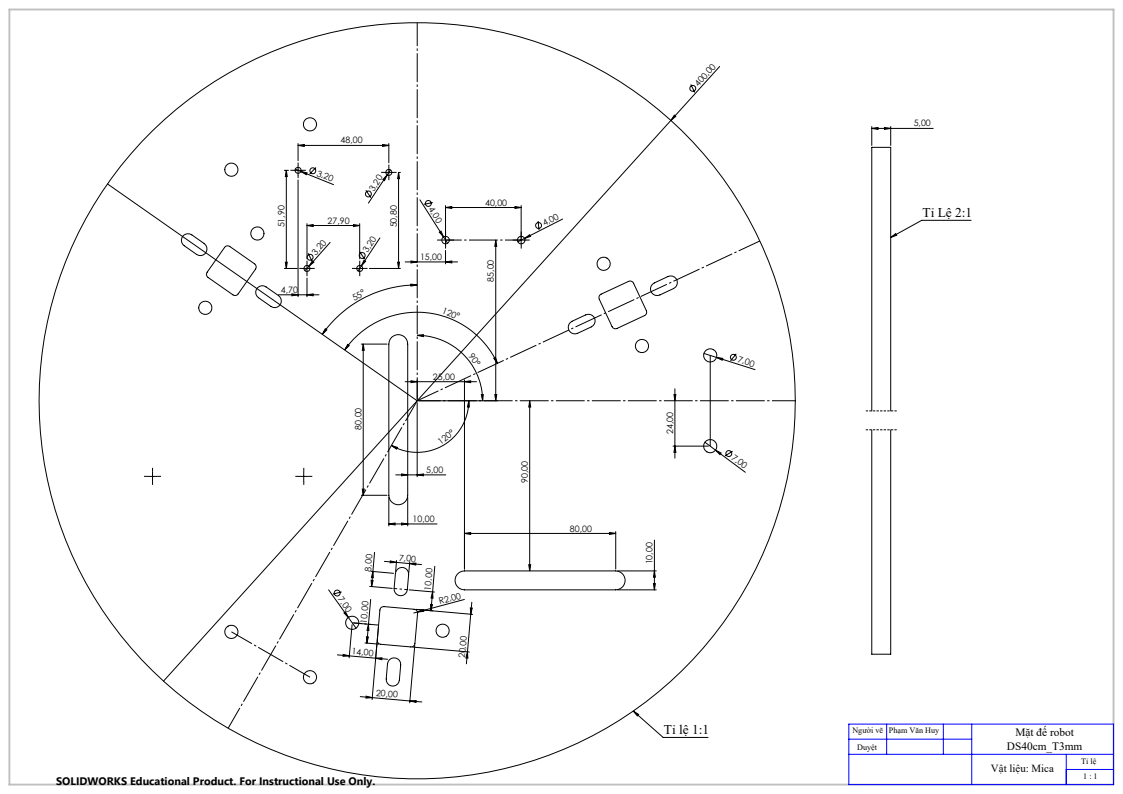
[picture p126: page 1]

Người vẽ | Phạm Văn Huy | | Mặt đế robot DS40cm_T3mm
Duyệt

Vật liệu: Mica | Tỉ lệ

1 : 1 SOLIDWORKS Educational Product. For Instructional Use Only.
