khiem13052003/three_wheel_omni_robot/config/ekf_params.yaml

frequency: 30
sensor_timeout: 0.2
two_d_mode: true
transform_time_offset: 0.0
transform_timeout: 0.2
print_diagnostics: true
debug: false
publish_tf: true
publish_acceleration: false

map_frame: map
odom_frame: odom
base_link_frame: base_link

# x, y, z
# roll, pitch, yaw
# vx, vy, vz
# vroll, vpitch, vyaw
# ax, ay, az.


odom0: /odom_raw
odom0_config: [true, true, false,
                false, false, true,
                true,  true, false,
                false, false, true,
                false, false, false]
odom0_queue_size: 3
odom0_rejection_threshold: 15
odom0_nodelay: false

imu0: imu/data_raw
imu0_config: [false, false, false,
              false, false, false,
              false, false, false,
              false, false, true,
              true,  true, false]
imu0_nodelay: false
imu0_differential: false
imu0_relative: true
imu0_queue_size: 5
imu0_remove_gravitational_acceleration: true
