khiem13052003/three_wheel_omni_robot/(commit log)

2025-06-21 change the way to get data from IMU
2025-07-12 add wheel odometry
    [base_link.STL, cam.STL, laser.STL, roller.urdf.xacro, urdf.urdf]
2026-04-22 add 3d model
    [1-3base.SLDPRT, Arduino.SLDPRT, Assem1.SLDASM, Assemly.SLDASM, BASE_R.SLDDRW, BASE_R.SLDPRT, BASE_R_F2.DXF, BASE_R_F2.SLDDRW]
